mkalkowski83/gas-detector/docs/gas-detector-mq.pdf

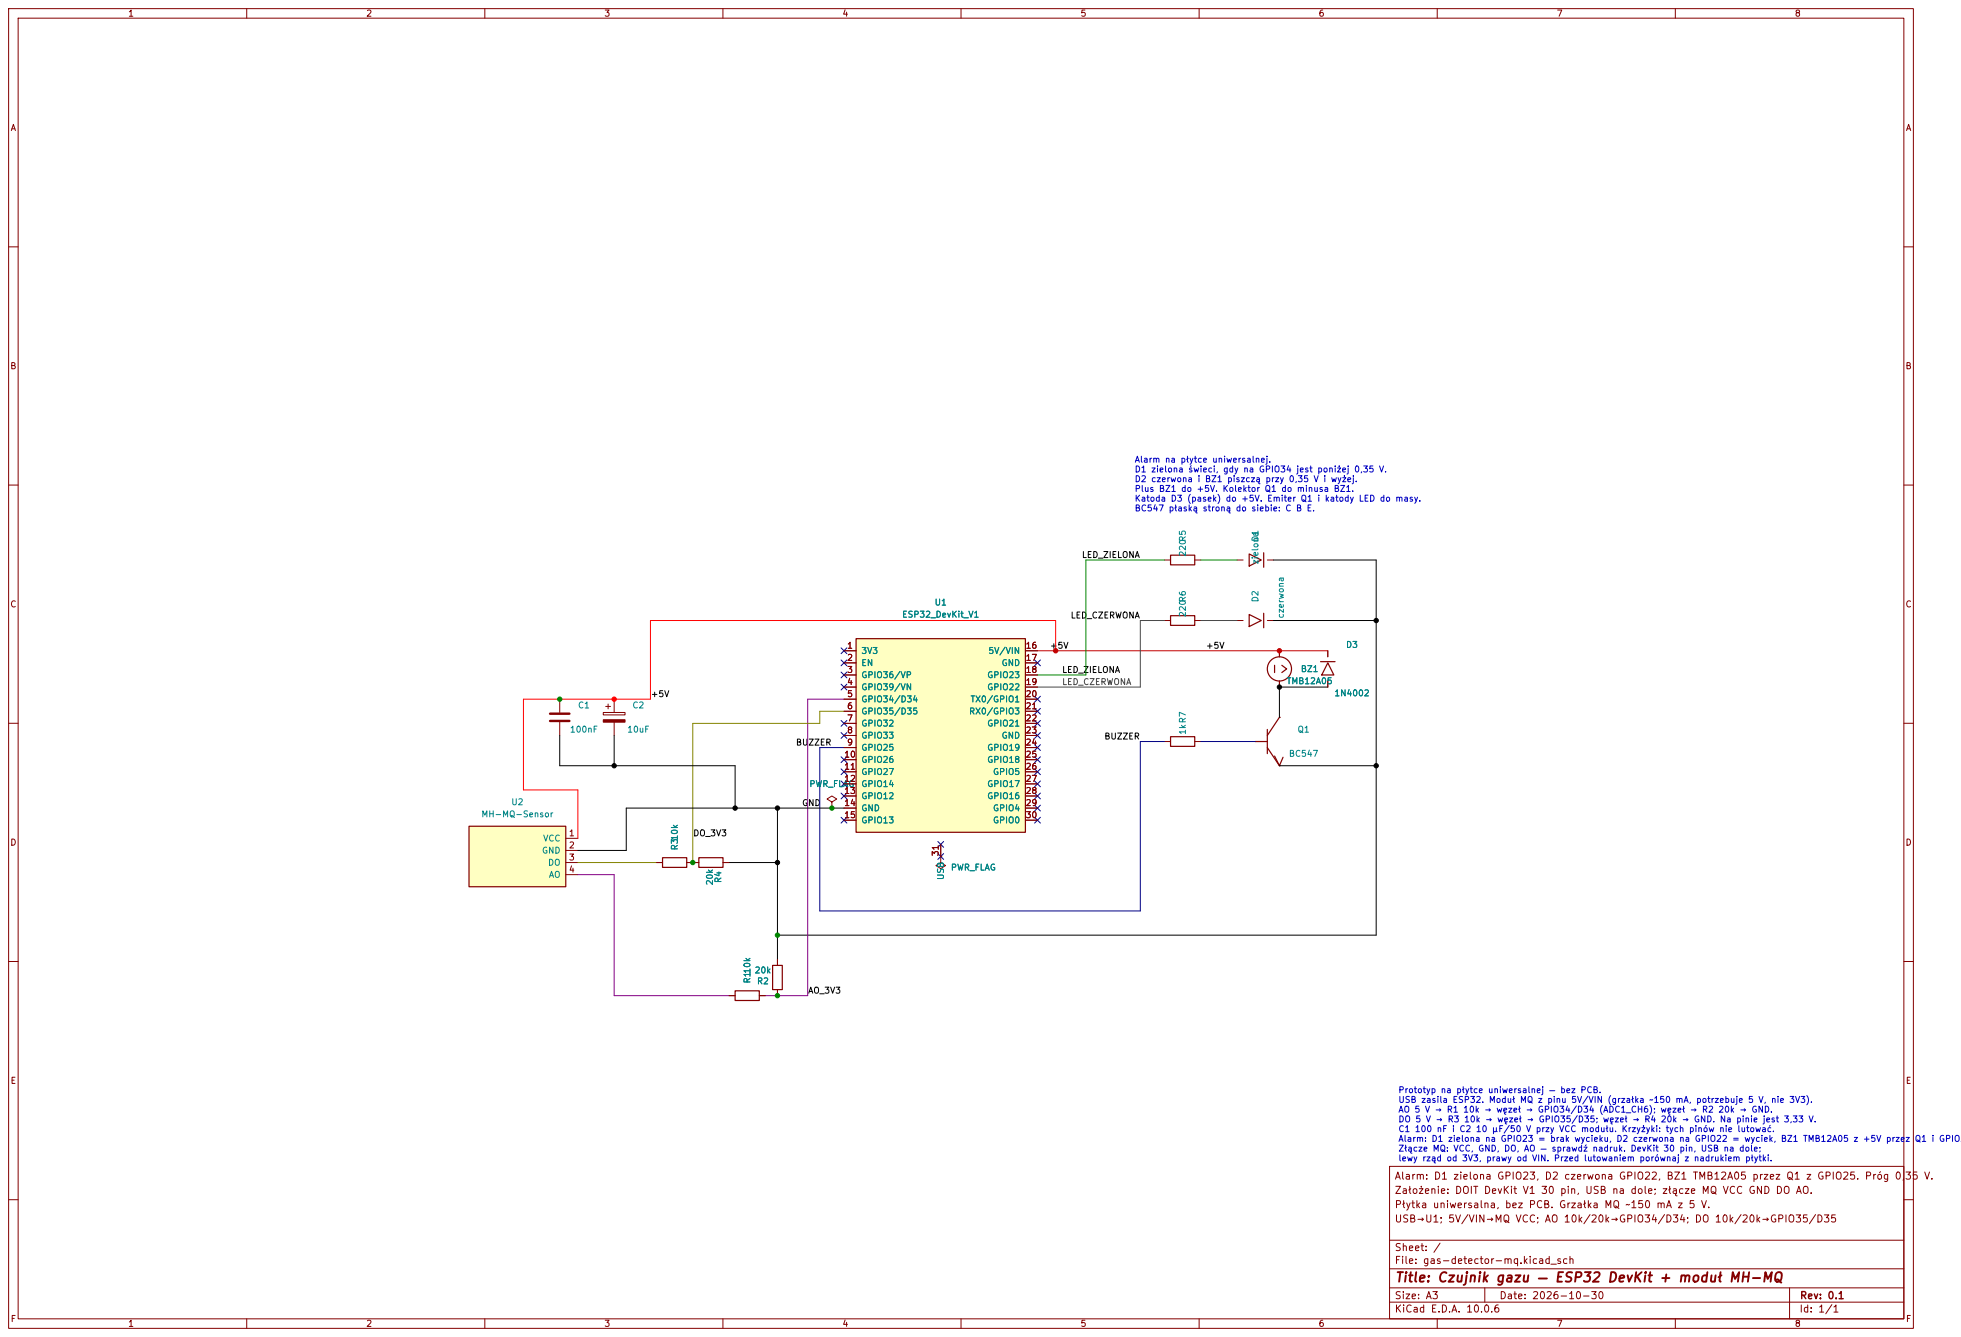
[picture p1: page 1]

Alarm: D1 zielona GPIO23, D2 czerwona GPIO22, BZ1 TMB12A05 przez Q1 z GPIO25. Próg 0,35 V. R5 220

lewy rząd od 3V3, prawy od VIN. Przed lutowaniem porównaj z nadrukiem płytki. PWR_FLAG

Założenie: DOIT DevKit V1 30 pin, USB na dole; złącze MQ VCC GND DO AO.
Płytka uniwersalna, bez PCB. Grzałka MQ ~150 mA z 5 V.
USB→U1; 5V/VIN→MQ VCC; AO 10k/20k→GPIO34/D34; DO 10k/20k→GPIO35/D35

Sheet: /
File: gas-detector-mq.kicad_sch
Title: Czujnik gazu — ESP32 DevKit + moduł MH-MQ

Size: A3 | Rev: 0.1 | F Date: 2026-10-30
KiCad E.D.A. 10.0.6 | Id: 1/1
