mkalkowski83/gas-detector/docs/kicad/gas-detector-mq/gas-detector-mq.kicad_sch

## KiCad design docs/kicad/gas-detector-mq/gas-detector-mq.kicad_sch (2026-11-06)

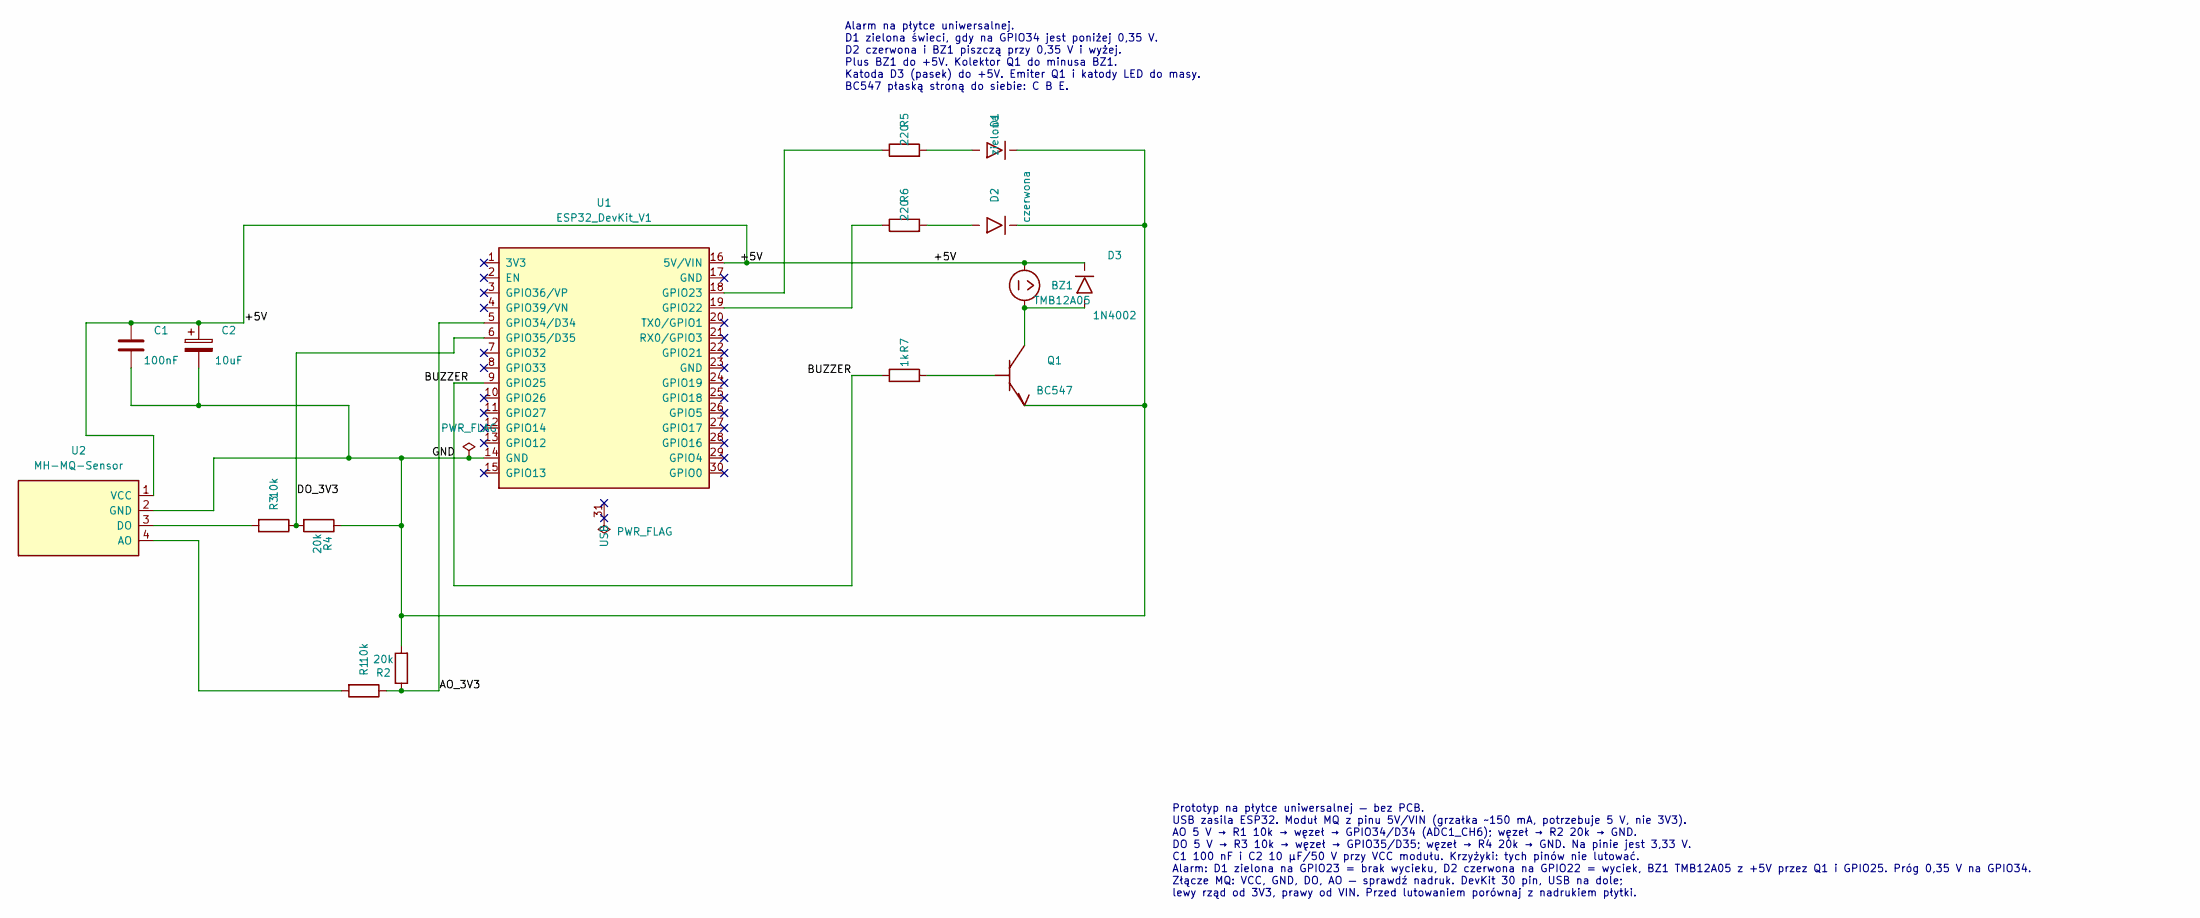
[picture p2: schematic gas-detector-mq.kicad_sch]

Parts:
BZ1: TMB12A05
C1: 100nF
C2: 10uF
D1: zielona
D2: czerwona
D3: 1N4002
Q1: BC547
R1, R3: 10k
R2, R4: 20k
R5, R6: 220
R7: 1k
U1: ESP32_DevKit_V1
U2: MH-MQ-Sensor

Connections:
+5V: BZ1.1 (+), C1.1, C2.1, D3.2 (K), U1.16 (5V/VIN), U2.1 (VCC)
AO_3V3: R1.1, R2.1, U1.5 (GPIO34/D34)
BUZZER: R7.1, U1.9 (GPIO25)
DO_3V3: R3.1, R4.2, U1.6 (GPIO35/D35)
GND: C1.2, C2.2, D1.2 (K), D2.2 (K), Q1.3 (E), R2.2, R4.1, U1.14 (GND), U2.2 (GND)
unnamed: BZ1.2 (-), D3.1 (A), Q1.2 (C)
unnamed: D1.1 (A), R5.2
unnamed: D2.1 (A), R6.2
unnamed: Q1.1 (B), R7.2
unnamed: R1.2, U2.4 (AO)
unnamed: R3.2, U2.3 (DO)
unnamed: R5.1, U1.18 (GPIO23)
unnamed: R6.1, U1.19 (GPIO22)

Notes on the sheet:
Alarm na płytce uniwersalnej. D1 zielona świeci, gdy na GPIO34 jest poniżej 0,35 V. D2 czerwona i BZ1 piszczą przy 0,35 V i wyżej. Plus BZ1 do +5V. Kolektor Q1 do minusa BZ1. Katoda D3 (pasek) do +5V. Emiter Q1 i katody LED do masy. BC547 płaską stroną do siebie: C B E.
Prototyp na płytce uniwersalnej — bez PCB. USB zasila ESP32. Moduł MQ z pinu 5V/VIN (grzałka ~150 mA, potrzebuje 5 V, nie 3V3). AO 5 V → R1 10k → węzeł → GPIO34/D34 (ADC1_CH6); węzeł → R2 20k → GND. DO 5 V → R3 10k → węzeł → GPIO35/D35; węzeł → R4 20k → GND. Na pinie jest 3,33 V. C1 100 nF i C2 10 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
