mkalkowski83/gas-detector/(commit log)

2026-11-02 Schemat KiCad: ESP32 DevKit + moduł MQ (bez PCB) (#1)
    * Dodaj schemat KiCad modułu MQ i ESP32 DevKit.
    Sam schemat pod płytkę uniwersalną: USB zasila DevKit, 5V/VIN zasila grzałkę modułu, a AO i DO schodzą dzielnikami 10k/20k na GPIO34 i GPIO32. Bez PCB.
    * Update schematic revision and adjust designators in KiCad files
    * Add power flag symbol to schematic and adjust wire connections
    * Add .gitignore entry for KiCad lock files in gas detector module
    * Add .gitignore entry for KiCad lock files in gas detector module
    * Przenieś DO modułu MQ na D35.
    AO zostaje na D34 (GPIO34). Wyjście cyfrowe DO idzie teraz na D35 (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
    [gas-detector-mq.kicad_sch]
2026-11-02 Refactor junctions and wires in KiCad schematic for improved layout
    [gas-detector-mq.kicad_sch]
2026-11-05 Diody alarmu i brzęczyk TMB12A05 na schemacie MQ (#2)
    * Dodaj diody alarmu i brzęczyk TMB12A05.
    Zielona na GPIO32 świeci poniżej 0,35 V, czerwona na GPIO33 i TMB12A05 przez BC547 z GPIO25 włączają się przy wycieku.
    * Wstaw na D3 diodę 1N4002.
    Ta prostownicza 1 A / 100 V gasi impuls cewki brzęczyka tak samo jak 1N4148.
    * Przenieś diody alarmu na GPIO23 i GPIO22.
    Zielona na D23 (GPIO23), czerwona na D22 (GPIO22). GPIO32 i GPIO33 zostają wolne.
    ---------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
    [gas-detector-mq.kicad_sch]
2026-11-05 cursor/gas-detector-alarm-leds-buzzer-7120 (#3)
    * Add .history to .gitignore to exclude history files
    * Refactor KiCad schematic: rename components and update properties for clarity
    * Refactor KiCad schematic: rename components and update properties for clarity
    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
    [gas-detector-mq.kicad_sch]
2026-11-05 Usuń update_interval z binarnego czujnika wycieku. (#5)
    binary_sensor.template nie przyjmuje tego pola. Stan idzie z odczytu ADC co 10 s.
2026-11-05 Fix secret key names in gas sensor configuration
2026-11-05 Translate comments in gas sensor configuration to English for better clarity (#6)
2026-11-06 Remove unused LED labels from gas detector schematic for cleaner layout
    [gas-detector-mq.kicad_sch]
